SohamBhavsar24/vision-autonomous-robotic-arm/poster/index.html

A0 Poster Controls

ISO A0 (841 x 1189 mm) @ 300 DPI

Magnification Preset

35% 42% 50% 60% 75% 85% 100% 115% 125%

Fit Width Fit Window

50%

Global Image Fit

Fill (Cover) Fit Entire (Contain)

Auto-Fit All Slots to Photos

Global Alignment

Center Top Bottom

Save All Changes

Saved all cards, slots & images!

Print / Export A0 PDF Reset Slot Sizes Reset Card Sizes Clear All Images

Pro Controls:
• Click Save All Changes to permanently store all images and layout sizing.
• In print preview: set Margins to None and Paper to ISO A0.
• Center column has the complete vertical pipeline.
• Drag bottom handle of any card or stage to customize height.
• Use [-H], [+H], [Auto] on card headers to adjust.
• Use [+ Add Image Window] on any card to create new image slots.
• Drag bottom handle of any slot to resize height.
• Use [Auto] on slots or Auto-Fit All Slots in dock to snap heights to image aspect ratio (eliminates all cropping).
• Use [Fit/Fill] and [Pos] on each slot for framing.

Department of Electrical and Electronics Engineering

# Vision-Guided Autonomous 6-DOF Robotic Arm

Overhead OpenCV Perception & Edge Intelligence on Raspberry Pi 5

Soham Bhavsar// Toshal Kumbhar// Divyansh Dewangan

+ College Logo

Upload Horizontal Logo / Seal

✕

1

## Problem & Innovation

-H +H Auto

Core Manipulation Dilemma: Traditional fixed automation fails when target objects shift unpredictably, while complex neural vision models introduce high latency and require heavy GPUs incompatible with standalone microcontrollers.

- Decoupled Perception: ArUco planar homography extracts physical coordinates in centimeters at 30 FPS without GPU overhead.
- Autonomous Motion Control: Cosine S-Curve velocity profiling and coordinated joint trajectory synthesis guarantee smooth, zero-jerk positioning without mechanical shock.
- Digital Twin & Teleoperation: WebGL 3D simulation enforces workspace geofencing and zero-collision safety; PS5 controller enables precise manual teleoperation.

Fit/Fill Pos Auto -H +H ✕ Del

Drop Image: Physical 6-DOF Arm

3D-Printed Manipulator on 25x30cm Grid

+ Add Image Window

2

## Hardware Architecture & Actuation

-H +H Auto

Manipulator Specs: 3D-printed links powered by an isolated 6V 5Ah battery rail with emergency cut-off. Arm reach: 35.0 cm.

Joint / Link | Actuator | Role / Dimension
Base Yaw | MG996R (Ch 0) | Turntable Pivot - L1 = 9.5 cm
Shoulder | MG996R (Ch 1) | Upper Arm - L2 = 12.0 cm
Elbow | MG996R (Ch 2) | Forearm - L3 = 9.0 cm
Wrist Roll/Pitch | MG90S (Ch 3,4) | Continuous Roll & Pitch
Gripper | MG90S (Ch 5) | Dual-Gear Claw - L4 = 14.0 cm

Control: Arduino Uno serial bridge (115200 baud, 0xFF binary packets at 30Hz) driving PCA9685 via 400kHz Fast I2C. 500ms watchdog auto-home timer.

+ Add Image Window

3

## Complete Physical Setup

-H +H Auto

Baseplate Rig

40 x 40 cm Rigid Frame

Camera Tower

50 cm Overhead Mast

Table Surface

25 x 30 cm Calibrated Pad

Power Delivery

Dual-Rail Isolated + Cutoff

- Rigid Baseplate: Anchored 40x40 cm frame absorbs dynamic reaction torques during rapid multi-axis manipulator motions.
- Overhead Camera Mast: 50 cm orthogonal mount secures the RGB camera for unoccluded top-down perception across pickup sectors.
- Calibrated Surface: 25x30 cm pad establishes precise homography coordinate bounds, staging zones, and drop bins.
- Isolated Dual-Rail Power: 6V 5A battery rail absorbs servo current surges, 5V rail powers logic circuits, with an emergency cutoff toggle.

Fit/Fill Pos Auto -H +H ✕ Del

Drop Image: Complete Physical Setup

Robotic Arm, Camera Mast, Baseplate & Workcell Rig

+ Add Image Window

SYSTEM ARCHITECTURE

## End-to-End System Pipeline

7-Stage Closed-Loop Cyber-Physical Workflow

STAGE 01 Logitech C270 USB • 30 FPS

-H +H Auto

Overhead Vision Capture & Frame Acquisition

Rigid 50 cm overhead mount acquires 640x480 MJPEG video at 30 FPS with fixed exposure, capturing the full 25x30 cm table workspace without perspective occlusion or illumination flicker.

Fit/Fill Pos Auto -H +H ✕

Drop Camera Feed

STAGE 02 OpenCV 5.0 • Sub-Pixel Tracking

-H +H Auto

ArUco Marker Perception & Detection

Real-time binary fiducial tracking isolates base origin (Tag 2) and pick block (Tag 0) in < 12 ms; sub-pixel corner refinement ensures sub-millimeter centroid and heading accuracy.

Fit/Fill Pos Auto -H +H ✕

Drop ArUco Tracking

STAGE 03 Planar Matrix H • Perspective Projection

-H +H Auto

Metric Real-World Homography Mapping

Calibrated 3x3 homography matrix H maps 2D camera pixels [u, v, 1]ᵀ directly to real-world table coordinates [X_w, Y_w, 1]ᵀ in centimeters with < 0.5 mm spatial precision.

STAGE 04 Coordinated Joint Profile • Zero-Jerk

-H +H Auto

Autonomous Motion Synthesis & Trajectory Generation

Synthesizes smooth joint-space waypoints using Cosine S-Curve velocity profiling, ensuring zero-jerk transitions, eliminating mechanical shock, and avoiding gear backlash.

Fit/Fill Pos Auto -H +H ✕

Drop Motion Trajectory

STAGE 05 115200 Baud • 400kHz Fast I2C

-H +H Auto

Binary Serial Protocol & Low-Level Driver

Streams compact 6-byte binary angle frames at 30 Hz with 0xFF sync header framing to Arduino Uno, commanding PCA9685 12-bit PWM servos over 400kHz Fast I2C.

STAGE 06 MG996R & MG90S • Dual-Rail Power

-H +H Auto

6-DOF Manipulator Actuation & Grasp Execution

Multi-axis servo actuation executes approach, descent, clamping, lift, and placement powered by an isolated 6V 5A battery rail with an active 500ms safety watchdog.

Fit/Fill Pos Auto -H +H ✕

Drop Physical Pick Action

STAGE 07 WebGL Three.js • 60 FPS Shadow

-H +H Auto

Digital Twin Shadow Validation & Safety Geofence

60 FPS Three.js 3D simulation mirrors manipulator poses in Shadow Mode, enforcing virtual workspace geofencing and verifying collision-free trajectories before physical actuation.

Fit/Fill Pos Auto -H +H ✕

Drop Digital Twin Simulation

4

## Perception & Teleop

-H +H Auto

- OpenCV 5.0 Perception: 30 FPS MJPEG. Marker ID 2 sets base origin (0,0); Marker ID 0 tracks cube.
- Calibrated Metric Space: Homography matrix H maps pixels directly to centimeters: Xmax = 30cm, Ymax = 25cm.
- Controller Teleoperation: Teleoperation is conducted using a handheld PS5 DualSense controller in Direct Joint Jogging mode with Exponential Moving Average (EMA) filtering (α=0.25) for smooth demonstration collection and real-time manual override.

Fit/Fill Pos Auto -H +H ✕ Del

Drop Image: OpenCV Stream

ArUco Bounding Boxes & Metric HUD

+ Add Image Window

5

## Digital Twin Simulation

-H +H Auto

01

Sim-to-Real Discrepancy: Compares servo joint telemetry against camera vision to detect motor stalls.

02

Workspace Geofencing: Virtual barrier prevents link collisions with camera mount or table.

03

Policy Shadow Mode: New policy checkpoints execute inside the 3D twin first; only collision-free paths actuate motors.

Fit/Fill Pos Auto -H +H ✕ Del

Drop Image: 3D Twin Viewport

STL Mesh Rendering & 25x30cm Pad

+ Add Image Window

6

## Performance Metrics

-H +H Auto

< 15 ms

Perception Latency

30 Hz

Control Loop Rate

60 FPS

Twin Sync Rate

< 0.8 cm

Repeatability Error

17,824

Training State Pairs

5.9 s

Policy Train Time

Accuracy: Angular MSE of 0.4038 degrees across all 30 workspace cells. Zero-Jerk S-Curve smoothing reduced motor acceleration spikes by 87%.

+ Add Image Window

7

## Standalone Edge Intelligence

-H +H Auto

Autonomous Raspberry Pi 5 Deployment: The entire system runs directly on a Raspberry Pi 5 (4GB RAM) as a 100% self-contained cyber-physical robotic cell.

- On-Device Loop: OpenCV 5.0 vision at 30 FPS; PyTorch BC policy executes in < 5 ms.
- Zero Cloud Dependency: Completely air-gapped without external network or latency.
- Dual-Rail Battery Isolation: 6V 5Ah SLA battery for servos; 5V 5A PD rail for Pi 5 with a 500ms safety watchdog auto-home timer.

+ Add Image Window
