SohamBhavsar24/vision-autonomous-robotic-arm/Robotic_Arm_3D_Model.STEP/Robotic Arm 3D Model.STEP

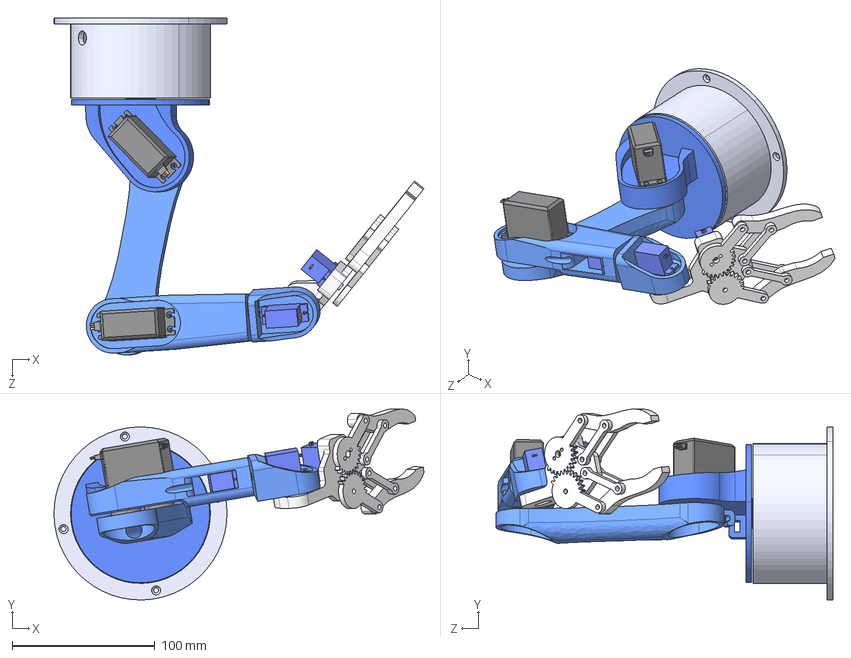
[picture p9: CAD file, 2026-09-26]
Robotic_Arm_3D_Model.STEP/Robotic Arm 3D Model.STEP
259.3 x 133.8 x 236.1 mm
Base
Servo Motor MG996R x 3
Waist
Arm 01
Servo Motor Micro 9g x 3
Arm 02 v3
Arm 03
gear1
gear2
grip link 1 x 4
Gripper base
Gripper 1 x 2
