SohamBhavsar24/vision-autonomous-robotic-arm/Robotic_Arm_3D_Model.STEP/grip link 1.STL

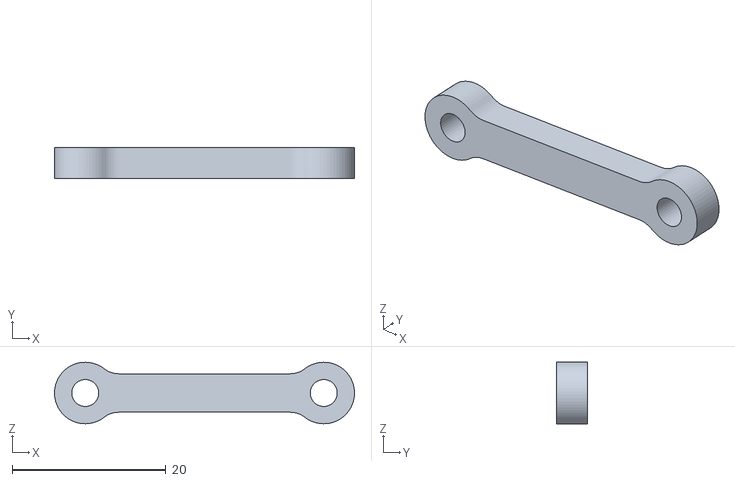
[picture p10: CAD file, 2026-09-20]
Robotic_Arm_3D_Model.STEP/grip link 1.STL
39.0 x 4.00 x 8.00
