SohamBhavsar24/vision-autonomous-robotic-arm/Robotic_Arm_3D_Model.STEP/Arm 03.STL

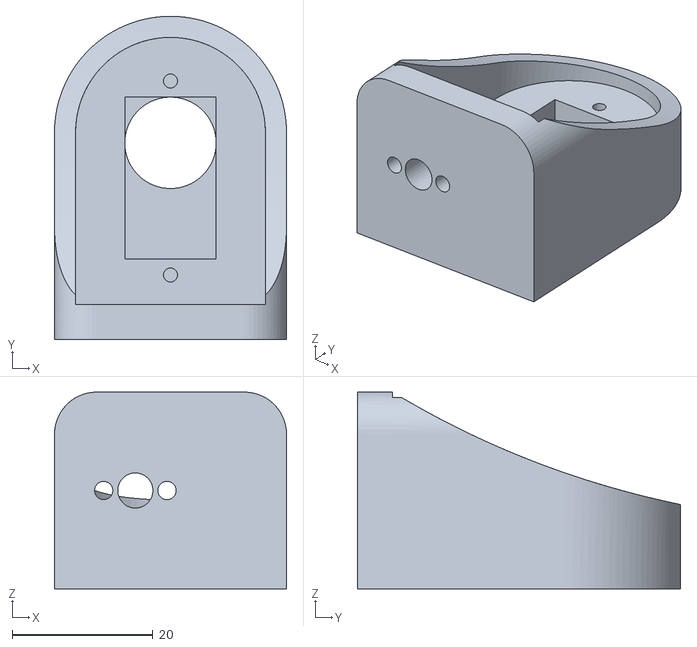
[picture p11: CAD file, 2026-09-20]
Robotic_Arm_3D_Model.STEP/Arm 03.STL
33.0 x 46.0 x 28.0
