SohamBhavsar24/vision-autonomous-robotic-arm/Robotic_Arm_3D_Model.STEP/Base.STL

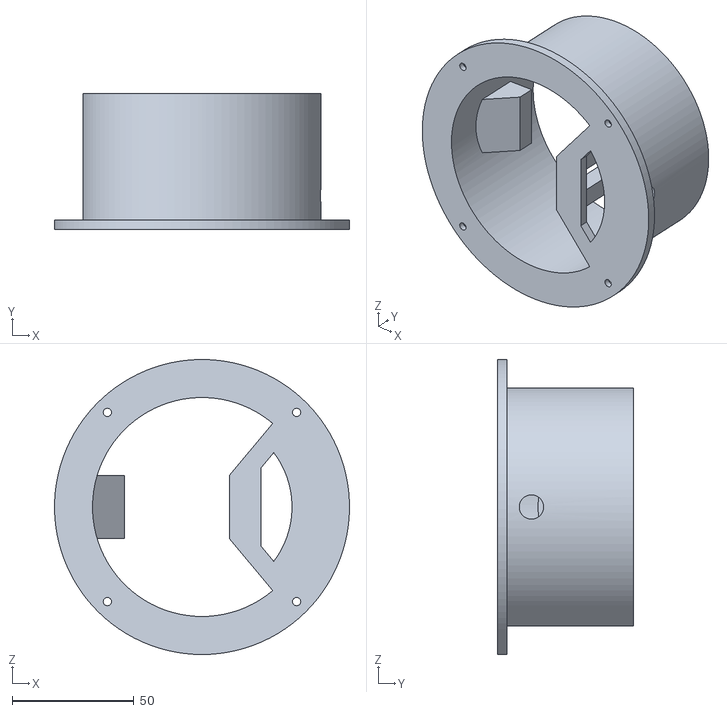
[picture p12: CAD file, 2026-09-20]
Robotic_Arm_3D_Model.STEP/Base.STL
121.2 x 56.0 x 121.2
