SohamBhavsar24/vision-autonomous-robotic-arm/Robotic_Arm_3D_Model.STEP/gear2.STL

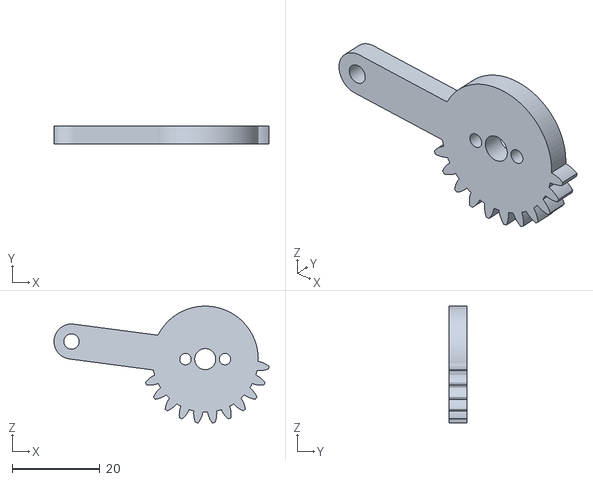
[picture p13: CAD file, 2026-09-20]
Robotic_Arm_3D_Model.STEP/gear2.STL
49.0 x 4.00 x 26.6
