SohamBhavsar24/vision-autonomous-robotic-arm/Robotic_Arm_3D_Model.STEP/Arm 01.STL

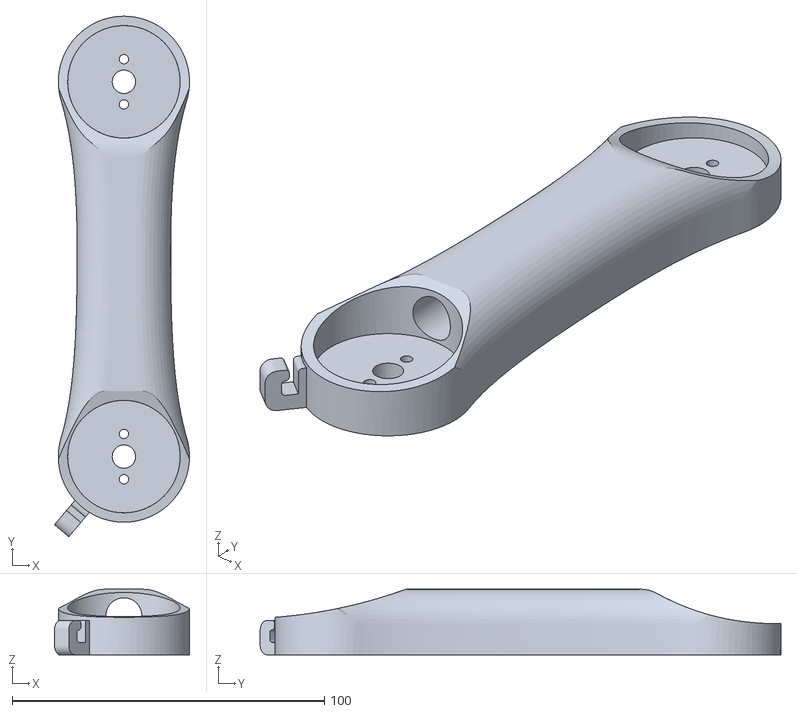
[picture p14: CAD file, 2026-09-20]
Robotic_Arm_3D_Model.STEP/Arm 01.STL
43.2 x 166.7 x 21.0
