SohamBhavsar24/vision-autonomous-robotic-arm/Robotic_Arm_3D_Model.STEP/Gripper base.STL

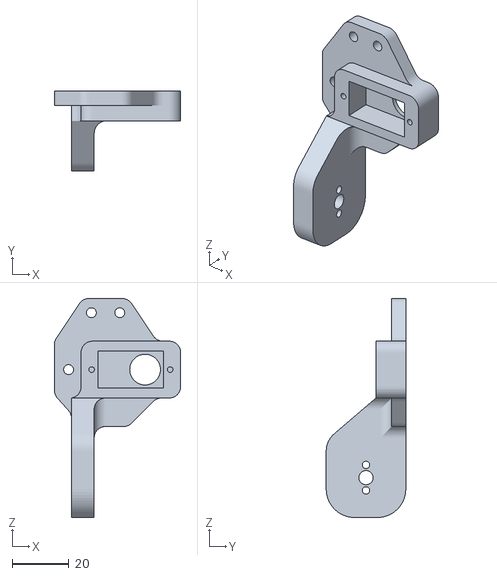
[picture p15: CAD file, 2026-09-20]
Robotic_Arm_3D_Model.STEP/Gripper base.STL
44.4 x 28.0 x 77.0
