SohamBhavsar24/vision-autonomous-robotic-arm/Robotic_Arm_3D_Model.STEP/Waist.STL

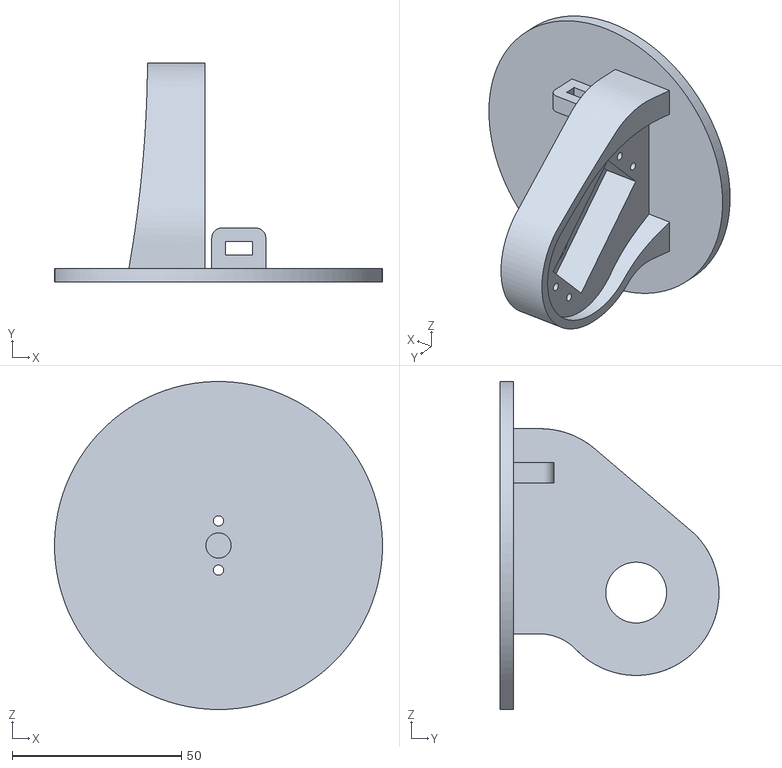
[picture p16: CAD file, 2026-09-20]
Robotic_Arm_3D_Model.STEP/Waist.STL
97.0 x 64.8 x 97.0
