SohamBhavsar24/vision-autonomous-robotic-arm/Robotic_Arm_3D_Model.STEP/Arm 02 v3.STL

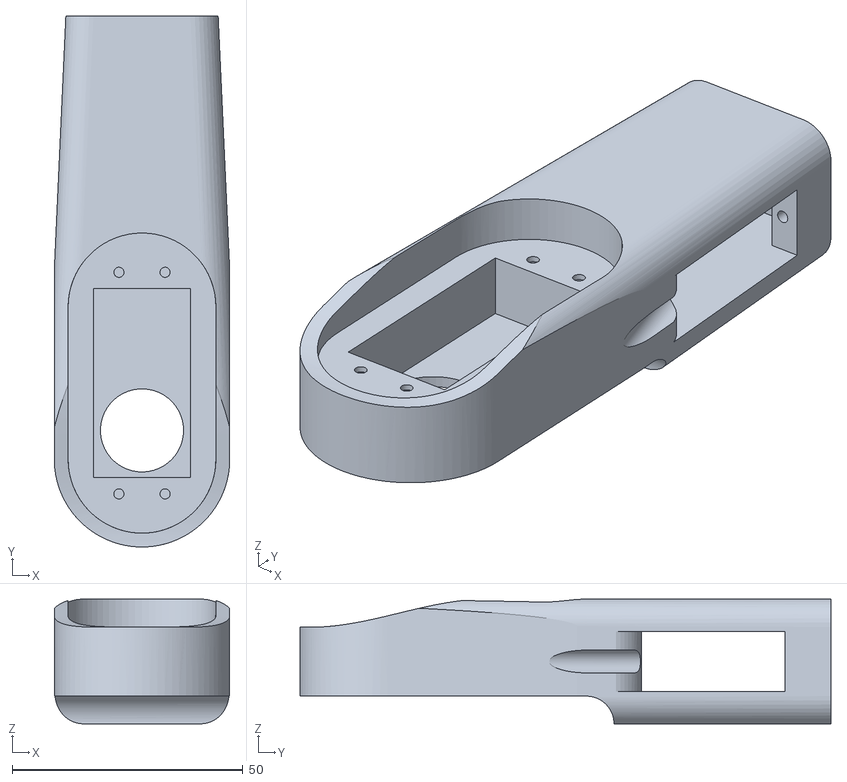
[picture p17: CAD file, 2026-09-20]
Robotic_Arm_3D_Model.STEP/Arm 02 v3.STL
38.0 x 115.0 x 27.0
