SohamBhavsar24/vision-autonomous-robotic-arm/Robotic_Arm_3D_Model.STEP/Gripper 1.STL

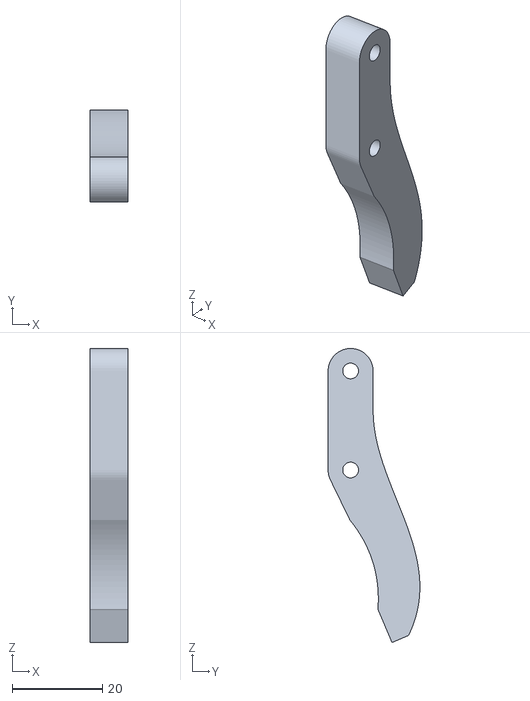
[picture p18: CAD file, 2026-09-20]
Robotic_Arm_3D_Model.STEP/Gripper 1.STL
8.50 x 20.4 x 65.3
