SohamBhavsar24/vision-autonomous-robotic-arm/(list of files, cad)

Other CAD files:
Robotic_Arm_3D_Model.STEP/gear1.STL
