SohamBhavsar24/vision-autonomous-robotic-arm/perception/aruco_markers/print_aruco_sheet.html

## Stage 1 Official ArUco Marker Print Sheet (DICT_4X4_50)

Mathematically Exact OpenCV Dictionary • Pre-scaled to 4cm × 4cm

Printing & Mounting Guide:

1. Click File → Print (or press Cmd+P / Ctrl+P).
2. In the Print Dialog, set Scale: 100% / Actual Size (do NOT fit to page).
3. Cut out each marker along the dashed outer border line.
4. CRITICAL STEP: Glue each cutout onto a flat piece of thin cardboard before sticking to the sponge cubes. Cardboard guarantees the marker stays 100% flat so vision detection works in variable lighting.
5. Attach Marker 0 to Block 1, Marker 1 to Block 2, and Marker 2 to Target Box.

Block 1 (Sponge Cube 1)

ArUco ID: 0 (4cm × 4cm)

Block 2 (Sponge Cube 2)

ArUco ID: 1 (4cm × 4cm)

Target Destination Box

ArUco ID: 2 (4cm × 4cm)
