SohamBhavsar24/vision-autonomous-robotic-arm/ps5_controller_test.html

# PS5 Controller Proof of Concept

Validating DualSense input via Browser Gamepad API

Press any button on your PS5 controller to connect...

## Analog Sticks

Left Stick

X: 0.00 Y: 0.00

Right Stick

X: 0.00 Y: 0.00

## Triggers & Bumpers

L2 Trigger

0%

R2 Trigger

0%

L1 Bumper

0%

R1 Bumper

0%

## Buttons

## Raw Axes

## Simulated Servo Mapping (Proof of Concept)

This shows how controller inputs would map to 6 servo angles (0°–180°). This is a placeholder mapping — the real IK solver will replace this.

Base (Ch 0) 90°

Shoulder (Ch 1) 90°

Elbow (Ch 2) 90°

Wrist Pitch (Ch 3) 90°

Wrist Roll (Ch 4) 90°

Gripper (Ch 5) 10°

How to test: Connect your PS5 DualSense controller via USB or Bluetooth to your Mac. Open this page in Chrome or Edge. Press any button on the controller — the browser will detect it automatically via the Gamepad API. Move the sticks and triggers to see live input values.

What this proves: That we can read all PS5 controller inputs (sticks, triggers, buttons) in real-time through a web browser with zero dependencies. The actual project will use a Python backend (FastAPI + pygame/pyserial) to read the controller and send commands to the Arduino — but this confirms the DualSense hardware works and is readable on your Mac.
