SohamBhavsar24/vision-autonomous-robotic-arm/dashboard/backend/main.py

"""
==============================================================================
DASHBOARD FASTAPI BACKEND SERVER
==============================================================================

Project:  Vision-Based Autonomous Robotic Arm
File:     main.py
Location: dashboard/backend/

PURPOSE:
    Asynchronous web server providing REST endpoints and WebSocket real-time
    communication for the Dashboard UI. Serves the static Warm Cream HTML/CSS/JS
    frontend and interfaces directly with serial_manager.py.

KEY ENDPOINTS:
    - GET  /api/ports             Lists available serial ports
    - POST /api/connect           Connects to a specific serial port
    - POST /api/disconnect        Disconnects from Arduino
    - POST /api/lock90            Locks all 6 servos at 90° for assembly
    - POST /api/home              Moves all servos to Home Position
    - POST /api/estop             Triggers Emergency Stop
    - POST /api/estop/reset       Resets Emergency Stop state
    - WS   /ws                    Real-time WebSocket for telemetry & slider streaming

RELATED DECISIONS:
    - Decision #11: Web-based Dashboard (FastAPI + WebSockets)
    - Decision #15: No authentication required
    - Decision #18: Warm light cream theme support
    - Decision #19: Active physical assembly tool
==============================================================================
"""

import os
import json
import asyncio
import logging
import urllib.request
import urllib.error
from typing import List, Dict, Any, Optional
from fastapi import FastAPI, WebSocket, WebSocketDisconnect, HTTPException, UploadFile, File
from fastapi.responses import StreamingResponse
from fastapi.staticfiles import StaticFiles
from fastapi.middleware.cors import CORSMiddleware
from pydantic import BaseModel

from serial_manager import serial_manager
from vision_manager import vision_manager_cam1
from ik_solver import ik_solver
from autonomous_runner import AutonomousRunner

autonomous_runner = AutonomousRunner(serial_manager=serial_manager, vision_manager=vision_manager_cam1)

logging.basicConfig(level=logging.INFO, format="%(asctime)s [%(levelname)s] %(message)s")
logger = logging.getLogger("DashboardBackend")

app = FastAPI(
    title="Robotic Arm Control Dashboard Backend",
    version="1.0.0"
)

UPLOADS_DIR = os.path.abspath(os.path.join(os.path.dirname(__file__), "../frontend/uploads"))
os.makedirs(UPLOADS_DIR, exist_ok=True)

def _load_env_file():
    possible_paths = [
        os.path.abspath(os.path.join(os.path.dirname(__file__), "../../.env")),
        os.path.abspath(os.path.join(os.path.dirname(__file__), ".env")),
        os.path.abspath(".env")
    ]
    for p in possible_paths:
        if os.path.exists(p):
            try:
                with open(p, "r", encoding="utf-8") as f:
                    for line in f:
                        line = line.strip()
                        if line and not line.startswith("#") and "=" in line:
                            k, v = line.split("=", 1)
                            os.environ.setdefault(k.strip(), v.strip().strip("'\""))
                break
            except Exception:
                pass

_load_env_file()

SUPABASE_URL = os.environ.get("SUPABASE_URL", "")
SUPABASE_KEY = os.environ.get("SUPABASE_KEY", "")

@app.post("/api/upload")
async def upload_media_file(file: UploadFile = File(...)):
    """Uploads media (video/photo/doc) locally and syncs to Supabase Cloud Storage."""
    clean_name = f"{int(asyncio.get_event_loop().time() * 1000)}_{file.filename.replace(' ', '_')}"
    local_path = os.path.join(UPLOADS_DIR, clean_name)
    
    contents = await file.read()
    with open(local_path, "wb") as f:
        f.write(contents)
        
    public_url = f"/uploads/{clean_name}"
    
    # Attempt background sync to Supabase Cloud Storage if credentials exist
    if SUPABASE_URL and SUPABASE_KEY:
        try:
            supa_url = f"{SUPABASE_URL}/storage/v1/object/journal-media/{clean_name}"
            req = urllib.request.Request(supa_url, data=contents, method="POST")
            req.add_header("apikey", SUPABASE_KEY)
            req.add_header("Authorization", f"Bearer {SUPABASE_KEY}")
            req.add_header("x-upsert", "true")
            req.add_header("Content-Type", file.content_type or "application/octet-stream")
            
            with urllib.request.urlopen(req) as resp:
                if resp.status in (200, 201):
                    public_url = f"{SUPABASE_URL}/storage/v1/object/public/journal-media/{clean_name}"
        except Exception as e:
            logger.warning(f"Cloud storage sync warning (using local URL): {e}")

    file_ext = file.filename.split(".")[-1].lower() if "." in file.filename else ""
    return {
        "status": "success",
        "name": file.filename,
        "type": file_ext,
        "url": public_url
    }

# Allow CORS for development
app.add_middleware(
    CORSMiddleware,
    allow_origins=["*"],
    allow_credentials=True,
    allow_methods=["*"],
    allow_headers=["*"],
)

# Track active WebSocket connections
active_connections: List[WebSocket] = []


# Request Models
class ConnectRequest(BaseModel):
    port: str
    baudrate: int = 115200


class ServoAnglesRequest(BaseModel):
    angles: List[int]


CONFIG_PATH = os.path.abspath(os.path.join(os.path.dirname(__file__), "kinematics_config.json"))
CLAW_CONFIG_PATH = os.path.abspath(os.path.join(os.path.dirname(__file__), "claw_config.json"))
CAMERA_CONFIG_PATH = os.path.abspath(os.path.join(os.path.dirname(__file__), "camera_config.json"))
JOURNAL_PATH = os.path.abspath(os.path.join(os.path.dirname(__file__), "journal_entries.json"))
DATASET_PATH = os.path.abspath(os.path.join(os.path.dirname(__file__), "dataset_episodes.json"))
DROP_LOCATIONS_PATH = os.path.abspath(os.path.join(os.path.dirname(__file__), "drop_locations.json"))
DATASETS_DIR = os.path.abspath(os.path.join(os.path.dirname(__file__), "datasets"))
os.makedirs(DATASETS_DIR, exist_ok=True)

class KinematicsConfigRequest(BaseModel):
    L1: float = 9.5
    L2: float = 12.0
    L3: float = 9.0
    L4: float = 14.0
    offsets: List[int] = [0, 0, 0, 0, 0, 0]
    gripper_closed: int = 85
    gripper_open: int = 140

class IKSolveRequest(BaseModel):
    x: float
    y: float
    z: float
    pitch_deg: float = 45.0
    roll_deg: float = 90.0
    gripper_angle: int = 140

class JournalEntriesRequest(BaseModel):
    entries: List[Dict[str, Any]]

class DatasetEpisodesRequest(BaseModel):
    episodes: List[Dict[str, Any]]

class DropLocationsSaveRequest(BaseModel):
    target_id: Optional[str] = None
    name: Optional[str] = None
    angles: Optional[List[int]] = None
    description: Optional[str] = None
    locations: Optional[Dict[str, Any]] = None

class AutonomousStartRequest(BaseModel):
    model_id: str = "v1"
    continuous: bool = True

class TrainModelRequest(BaseModel):
    version_id: str = "v1"
    model_name: str = "v1 (30 Demos)"
    epochs: int = 80
    include_theta: Optional[bool] = None
    architecture: str = "mlp"


from dataset_formatter import save_compact_dataset_file, save_individual_episodes, load_individual_episodes

@app.on_event("shutdown")
def shutdown_event():
    logger.info("Stopping vision manager camera streams...")
    vision_manager_cam1.stop_camera()


@app.get("/api/video_feed/1")
async def video_feed_cam1():
    """Live MJPEG video feed for Camera 1 (Logitech C270 Workspace View) with real-time OpenCV ArUco Marker ID 0 detection."""
    return StreamingResponse(
        vision_manager_cam1.generate_mjpeg_stream(),
        media_type="multipart/x-mixed-replace; boundary=frame"
    )


@app.get("/api/vision/status")
async def get_vision_status():
    """Returns camera connection status, detected ArUco IDs, and real-world block pose relative to Origin Tag ID 2."""
    return {
        "camera1_connected": vision_manager_cam1.is_camera_connected,
        "detected_marker_ids": vision_manager_cam1.last_detected_ids,
        "latest_block_pose": vision_manager_cam1.latest_block_pose
    }


@app.get("/api/dataset")
async def get_dataset_episodes():
    """Returns persistent list of recorded demonstration episodes from individual JSON files."""
    return load_individual_episodes(DATASETS_DIR, DATASET_PATH)


@app.post("/api/dataset")
async def save_dataset_episodes(req: DatasetEpisodesRequest):
    """Saves persistent list of demonstration episodes into individual episode_XXX.json files in datasets/."""
    save_individual_episodes(req.episodes, DATASETS_DIR, DATASET_PATH)
    return {"status": "saved", "count": len(req.episodes)}


@app.get("/api/journal")
async def get_journal_entries():
    """Returns shared master list of journal entries."""
    if os.path.exists(JOURNAL_PATH):
        try:
            with open(JOURNAL_PATH, "r") as f:
                return json.load(f)
        except Exception:
            pass

    # Fallback to Supabase if local file does not exist but credentials do
    if SUPABASE_URL and SUPABASE_KEY:
        try:
            endpoint = f"{SUPABASE_URL}/rest/v1/journal_entries?select=*&order=created_at.desc"
            req = urllib.request.Request(endpoint)
            req.add_header("apikey", SUPABASE_KEY)
            req.add_header("Authorization", f"Bearer {SUPABASE_KEY}")
            with urllib.request.urlopen(req, timeout=5) as resp:
                if resp.status == 200:
                    data = json.loads(resp.read().decode("utf-8"))
                    if isinstance(data, list):
                        return data
        except Exception as e:
            logger.warning(f"Supabase journal fetch warning: {e}")

    return []


@app.post("/api/journal")
async def save_journal_entries(req: JournalEntriesRequest):
    """Saves shared master list of journal entries to backend file and syncs to Supabase."""
    with open(JOURNAL_PATH, "w") as f:
        json.dump(req.entries, f, indent=2)

    # Sync to Supabase PostgreSQL table if credentials exist
    if SUPABASE_URL and SUPABASE_KEY:
        try:
            endpoint = f"{SUPABASE_URL}/rest/v1/journal_entries"
            data = json.dumps(req.entries).encode("utf-8")
            sync_req = urllib.request.Request(endpoint, data=data, method="POST")
            sync_req.add_header("apikey", SUPABASE_KEY)
            sync_req.add_header("Authorization", f"Bearer {SUPABASE_KEY}")
            sync_req.add_header("Content-Type", "application/json")
            sync_req.add_header("Prefer", "resolution=merge-duplicates,return=representation")
            with urllib.request.urlopen(sync_req, timeout=5) as resp:
                pass
        except Exception as e:
            logger.warning(f"Supabase journal sync warning: {e}")

    return {"status": "saved", "count": len(req.entries)}


@app.delete("/api/journal")
@app.delete("/api/journal/{entry_id}")
async def delete_journal_entry(entry_id: Optional[str] = None, id: Optional[str] = None):
    """Deletes an entry from local JSON and Supabase if configured."""
    target_id = entry_id or id
    if not target_id:
        raise HTTPException(status_code=400, detail="Missing entry id")

    if os.path.exists(JOURNAL_PATH):
        try:
            with open(JOURNAL_PATH, "r") as f:
                entries = json.load(f)
            entries = [e for e in entries if e.get("id") != target_id]
            with open(JOURNAL_PATH, "w") as f:
                json.dump(entries, f, indent=2)
        except Exception as e:
            logger.warning(f"Local entry delete warning: {e}")

    if SUPABASE_URL and SUPABASE_KEY:
        try:
            endpoint = f"{SUPABASE_URL}/rest/v1/journal_entries?id=eq.{target_id}"
            del_req = urllib.request.Request(endpoint, method="DELETE")
            del_req.add_header("apikey", SUPABASE_KEY)
            del_req.add_header("Authorization", f"Bearer {SUPABASE_KEY}")
            with urllib.request.urlopen(del_req, timeout=5) as resp:
                pass
        except Exception as e:
            logger.warning(f"Supabase entry delete warning: {e}")

    return {"status": "deleted", "id": target_id}


@app.get("/api/kinematics")
async def get_kinematics_config():
    """Returns persistent Kinematic Calibration parameters."""
    if os.path.exists(CONFIG_PATH):
        try:
            with open(CONFIG_PATH, "r") as f:
                return json.load(f)
        except Exception:
            pass
    return {
        "L1": 9.5, "L2": 12.0, "L3": 9.0, "L4": 14.0,
        "offsets": [0, 0, 0, 0, 0, 0],
        "gripper_closed": 85, "gripper_open": 140
    }


@app.post("/api/kinematics")
async def save_kinematics_config(req: KinematicsConfigRequest):
    """Saves updated Kinematic Calibration parameters (L1-L4, offsets, gripper angles) and syncs to ik_solver and serial_manager."""
    data = req.model_dump()
    with open(CONFIG_PATH, "w") as f:
        json.dump(data, f, indent=2)
    ik_solver.L1 = req.L1
    ik_solver.L2 = req.L2
    ik_solver.L3 = req.L3
    ik_solver.L4 = req.L4
    serial_manager.gripper_open = req.gripper_open
    serial_manager.gripper_closed = req.gripper_closed
    return {"status": "saved", "config": data}


@app.get("/api/digital_twin/claw_config")
async def get_claw_config():
    """Returns persistent digital twin claw placement parameters."""
    if os.path.exists(CLAW_CONFIG_PATH):
        try:
            with open(CLAW_CONFIG_PATH, "r") as f:
                return json.load(f)
        except Exception as e:
            logger.warning(f"Error loading claw_config.json: {e}")
    return {}


@app.post("/api/digital_twin/claw_config")
async def save_claw_config(config: dict):
    """Saves updated digital twin claw placement parameters."""
    try:
        with open(CLAW_CONFIG_PATH, "w") as f:
            json.dump(config, f, indent=2)
        return {"status": "saved", "config": config}
    except Exception as e:
        logger.error(f"Error saving claw_config.json: {e}")
        return {"status": "error", "message": str(e)}


@app.get("/api/digital_twin/camera_default")
async def get_camera_default():
    """Returns persistent digital twin default camera viewpoint."""
    if os.path.exists(CAMERA_CONFIG_PATH):
        try:
            with open(CAMERA_CONFIG_PATH, "r") as f:
                return json.load(f)
        except Exception as e:
            logger.warning(f"Error loading camera_config.json: {e}")
    return {}


@app.post("/api/digital_twin/camera_default")
async def save_camera_default(config: dict):
    """Saves updated digital twin default camera viewpoint to disk."""
    try:
        with open(CAMERA_CONFIG_PATH, "w") as f:
            json.dump(config, f, indent=2)
        return {"status": "saved", "config": config}
    except Exception as e:
        logger.error(f"Error saving camera_config.json: {e}")
        return {"status": "error", "message": str(e)}


def load_drop_locations_dict() -> Dict[str, Any]:
    """Loads drop_locations.json or returns and initializes default locations."""
    if os.path.exists(DROP_LOCATIONS_PATH):
        try:
            with open(DROP_LOCATIONS_PATH, "r") as f:
                return json.load(f)
        except Exception as e:
            logger.warning(f"Error loading drop_locations.json: {e}")
    default_locs = {
        "block_1": {
            "name": "Block 1 Drop Target (Tag 0)",
            "angles": [140, 80, 85, 90, 90],
            "description": "Calibrated drop target for Block 1 (ArUco ID 0) left bin"
        },
        "block_2": {
            "name": "Block 2 Drop Target (Tag 1)",
            "angles": [155, 80, 85, 90, 90],
            "description": "Calibrated drop target for Block 2 (ArUco ID 1) outer left bin"
        }
    }
    try:
        with open(DROP_LOCATIONS_PATH, "w") as f:
            json.dump(default_locs, f, indent=2)
    except Exception as e:
        logger.error(f"Error initializing drop_locations.json: {e}")
    return default_locs


@app.get("/api/drop_locations")
async def get_drop_locations():
    """Returns persistent calibrated drop targets for Block 1, Block 2, and high-clearance transit waypoint."""
    data = load_drop_locations_dict()
    return {"status": "success", "locations": data}


@app.post("/api/drop_locations")
async def save_drop_locations(req: DropLocationsSaveRequest):
    """
    Saves updated drop target coordinates.
    Supports single-target updates (target_id + angles) or bulk updates (locations dict).
    Stores only the 5 arm kinematic joint angles [θ1..θ5], strictly adhering to Decision #37.
    """
    current_data = load_drop_locations_dict()

    if req.target_id and req.angles is not None:
        clamped_angles = [max(0, min(180, int(round(a)))) for a in req.angles[:5]]
        if len(clamped_angles) < 5:
            raise HTTPException(status_code=400, detail="Drop location must specify 5 arm joint angles [θ1..θ5].")
        target_info = current_data.get(req.target_id, {})
        target_info["angles"] = clamped_angles
        if req.name:
            target_info["name"] = req.name
        if req.description:
            target_info["description"] = req.description
        current_data[req.target_id] = target_info

    elif req.locations:
        for tid, tinfo in req.locations.items():
            if isinstance(tinfo, dict) and "angles" in tinfo:
                clamped_angles = [max(0, min(180, int(round(a)))) for a in tinfo["angles"][:5]]
                if len(clamped_angles) == 5:
                    target_entry = current_data.get(tid, {})
                    target_entry["angles"] = clamped_angles
                    if "name" in tinfo:
                        target_entry["name"] = tinfo["name"]
                    if "description" in tinfo:
                        target_entry["description"] = tinfo["description"]
                    current_data[tid] = target_entry

    try:
        with open(DROP_LOCATIONS_PATH, "w") as f:
            json.dump(current_data, f, indent=2)
        return {"status": "saved", "locations": current_data}
    except Exception as e:
        logger.error(f"Error saving drop_locations.json: {e}")
        return {"status": "error", "message": str(e)}


@app.post("/api/drop_locations/test/{target_id}")
async def test_drop_location_pose(target_id: str):
    """
    Executes a smooth zero-jerk Cosine S-Curve test transition to the specified calibrated drop pose.
    Dynamically loads the live open gripper angle from serial_manager (Decision #37).
    """
    locations = load_drop_locations_dict()
    if target_id not in locations:
        raise HTTPException(status_code=404, detail=f"Target drop location '{target_id}' not found.")

    target_angles_5 = locations[target_id]["angles"][:5]
    open_angle = getattr(serial_manager, "gripper_open", 140)
    target_angles_6 = target_angles_5 + [open_angle]

    success, msg = await serial_manager.smooth_transition_to_angles(
        target_angles_6,
        duration_sec=1.5
    )
    return {
        "status": "success" if success else "error",
        "message": msg,
        "target_id": target_id,
        "angles": target_angles_6
    }


@app.post("/api/drop_locations/test_sequence/{target_id}")
async def test_drop_location_sequence(target_id: str):
    """
    Executes complete decoupled transfer test sequence:
    1. Smooth S-Curve directly to target drop pose (holding block)
    2. Momentarily commands calibrated open angle to release (Decision #37)
    3. Smooth S-Curve return directly to Home position
    """
    locations = load_drop_locations_dict()
    if target_id not in locations:
        raise HTTPException(status_code=404, detail=f"Target drop location '{target_id}' not found.")

    target_angles_5 = locations[target_id]["angles"][:5]
    open_angle = getattr(serial_manager, "gripper_open", 140)
    closed_angle = getattr(serial_manager, "gripper_closed", 85)

    # 1. Target Drop Bin (holding block)
    drop_angles = target_angles_5 + [closed_angle]
    ok, msg = await serial_manager.smooth_transition_to_angles(drop_angles, duration_sec=1.2)
    if not ok:
        return {"status": "error", "message": f"Drop pose failed: {msg}"}

    # 2. Release gripper (dynamically use open angle)
    release_angles = target_angles_5 + [open_angle]
    ok, msg = await serial_manager.smooth_transition_to_angles(release_angles, duration_sec=0.5)
    await asyncio.sleep(0.3)

    # 3. Return smoothly directly to Home
    ok, msg = await serial_manager.move_to_home()
    return {"status": "success", "message": f"Drop sequence for '{target_id}' completed successfully."}


@app.post("/api/ik/solve")
async def solve_ik_endpoint(req: IKSolveRequest):
    """Solves 3D Analytical Inverse Kinematics for target (X, Y, Z) in cm."""
    angles, reachable, msg = ik_solver.solve_ik(
        x=req.x, y=req.y, z=req.z,
        pitch_deg=req.pitch_deg, roll_deg=req.roll_deg,
        gripper_angle=req.gripper_angle
    )
    return {
        "status": "success" if reachable else "warning",
        "reachable": reachable,
        "angles": angles,
        "message": msg,
        "target": {"x": req.x, "y": req.y, "z": req.z, "pitch_deg": req.pitch_deg, "roll_deg": req.roll_deg}
    }


@app.post("/api/ik/move")
async def move_ik_endpoint(req: IKSolveRequest):
    """Solves 3D IK and smoothly dispatches calculated joint angles to physical servos."""
    angles, reachable, msg = ik_solver.solve_ik(
        x=req.x, y=req.y, z=req.z,
        pitch_deg=req.pitch_deg, roll_deg=req.roll_deg,
        gripper_angle=req.gripper_angle
    )
    success, send_msg = serial_manager.send_angles(angles)
    await broadcast_status()
    return {
        "status": "success" if (reachable and success) else "warning",
        "reachable": reachable,
        "angles": angles,
        "message": f"{msg} | Serial: {send_msg}",
        "target": {"x": req.x, "y": req.y, "z": req.z, "pitch_deg": req.pitch_deg, "roll_deg": req.roll_deg}
    }


@app.get("/api/fk")
async def get_forward_kinematics():
    """Computes and returns current 3D Cartesian coordinates (X, Y, Z in cm) of the physical arm."""
    current_angles = serial_manager.current_angles
    fk_res = ik_solver.forward_kinematics(*current_angles)
    return {
        "status": "success",
        "current_angles": current_angles,
        "cartesian": fk_res
    }


@app.get("/api/ports")
async def list_ports():
    """Lists available serial ports."""
    return {"ports": serial_manager.list_available_ports()}


@app.post("/api/connect")
async def connect_port(req: ConnectRequest):
    """Connects to specified serial port."""
    success, msg = serial_manager.connect(req.port, req.baudrate)
    if not success:
        raise HTTPException(status_code=400, detail=msg)
    await broadcast_status()
    return {"status": "connected", "message": msg}


@app.post("/api/auto-connect")
async def auto_connect_port():
    """Auto-detects and connects to Arduino."""
    success, msg = serial_manager.auto_connect()
    if not success:
        raise HTTPException(status_code=400, detail=msg)
    await broadcast_status()
    return {"status": "connected", "message": msg}


@app.post("/api/disconnect")
async def disconnect_port():
    """Disconnects serial connection."""
    success, msg = serial_manager.disconnect()
    await broadcast_status()
    return {"status": "disconnected", "message": msg}


@app.post("/api/servos")
async def set_servo_angles(req: ServoAnglesRequest):
    """Sets 6 servo angles (0–180)."""
    success, msg = serial_manager.send_angles(req.angles)
    if not success:
        raise HTTPException(status_code=400, detail=msg)
    await broadcast_status()
    return {"status": "success", "angles": serial_manager.current_angles}


@app.post("/api/lock90")
async def lock_all_90():
    """Locks all servos at 90° for assembly (Decision #19)."""
    asyncio.create_task(serial_manager.lock_all_90(broadcast_callback=broadcast_status))
    return {"status": "success", "message": "Locking all servos at 90°"}


@app.post("/api/home")
async def move_home():
    """Moves all servos to Home Position."""
    asyncio.create_task(serial_manager.move_to_home(broadcast_callback=broadcast_status))
    return {"status": "success", "message": "Moving to Home Position"}


@app.post("/api/servos/test/{servo_index}")
async def test_servo(servo_index: int):
    """Performs a solo sweep test on a single servo for assembly diagnostics."""
    asyncio.create_task(serial_manager.test_single_servo(servo_index, broadcast_callback=broadcast_status))
    return {"status": "success", "message": f"Testing Servo {servo_index}"}


@app.post("/api/estop")
async def emergency_stop():
    """Triggers Emergency Stop."""
    success, msg = serial_manager.emergency_stop()
    await broadcast_status()
    return {"status": "estop_active", "message": msg}


@app.post("/api/estop/reset")
async def reset_estop():
    """Resets Emergency Stop state."""
    success, msg = serial_manager.reset_estop()
    await broadcast_status()
    return {"status": "estop_reset", "message": msg}


# Autonomous Policy Execution Endpoints (Phase D)

@app.get("/api/models")
async def get_models():
    """Returns list of registered trained model versions."""
    return {"models": autonomous_runner.get_available_models()}


@app.post("/api/models/train")
async def train_new_model(req: TrainModelRequest):
    """Triggers policy training on recorded dataset episodes."""
    if req.architecture.lower() == "act" or req.version_id.startswith("act_") or "act" in req.model_name.lower():
        from train_act_engine import train_act_model
        meta = train_act_model(
            version_id=req.version_id,
            model_name=req.model_name,
            epochs=req.epochs or 30,
            include_theta=req.include_theta
        )
    else:
        from train_policy_engine import train_model
        meta = train_model(version_id=req.version_id, model_name=req.model_name, epochs=req.epochs, include_theta=req.include_theta)
    await broadcast_status()
    return {"status": "trained", "model": meta}


@app.delete("/api/models/{model_id}")
@app.post("/api/models/{model_id}/delete")
async def delete_model_endpoint(model_id: str):
    """Deletes a registered trained policy model and removes its file from disk."""
    if autonomous_runner.is_running and autonomous_runner.current_model_id == model_id:
        raise HTTPException(status_code=400, detail="Cannot delete model while autonomous execution is active.")
        
    success, msg = autonomous_runner.delete_model(model_id)
    if not success:
        raise HTTPException(status_code=404, detail=msg)
        
    await broadcast_status()
    return {"status": "deleted", "message": msg}


@app.get("/api/autonomous/status")
async def get_autonomous_status():
    """Returns live execution status, phase, and progress of the autonomous runner."""
    return autonomous_runner.get_status()


@app.post("/api/autonomous/start")
async def start_autonomous_execution(req: AutonomousStartRequest):
    """Starts autonomous pick-and-place execution using the selected model."""
    if autonomous_runner.is_running or autonomous_runner.is_loop_active:
        raise HTTPException(status_code=400, detail="Autonomous execution is already active.")
    
    if req.continuous:
        success, msg = autonomous_runner.start_autonomous_loop(
            model_id=req.model_id,
            broadcast_callback=broadcast_status
        )
        if not success:
            raise HTTPException(status_code=400, detail=msg)
        await broadcast_status()
        return {"status": "started", "mode": "continuous", "model_id": req.model_id}
    else:
        asyncio.create_task(autonomous_runner.run_autonomous_policy(
            model_id=req.model_id,
            broadcast_callback=broadcast_status
        ))
        return {"status": "started", "mode": "single", "model_id": req.model_id}


@app.post("/api/autonomous/stop")
async def stop_autonomous_execution():
    """Aborts or stops the active autonomous execution."""
    success, msg = autonomous_runner.stop_autonomous_loop()
    await broadcast_status()
    return {"status": "stopped" if success else "failed", "message": msg}


# WebSocket Handler for Real-Time Telemetry & Slider Control

@app.websocket("/ws")
async def websocket_endpoint(websocket: WebSocket):
    await websocket.accept()
    active_connections.append(websocket)
    logger.info("New WebSocket client connected.")
    
    # Send initial status on connect
    initial_status = serial_manager.get_status()
    initial_status["latest_block_pose"] = vision_manager_cam1.latest_block_pose
    await websocket.send_json({"type": "status", "data": initial_status})

    try:
        while True:
            data_str = await websocket.receive_text()
            try:
                data = json.loads(data_str)
                action_type = data.get("type")

                if action_type == "set_angles":
                    angles = data.get("angles", [])
                    serial_manager.send_angles(angles)
                    await broadcast_status()

                elif action_type == "move_ik":
                    x = float(data.get("x", 0.0))
                    y = float(data.get("y", 20.0))
                    z = float(data.get("z", 5.0))
                    pitch_deg = float(data.get("pitch_deg", -30.0))
                    roll_deg = float(data.get("roll_deg", 90.0))
                    gripper_angle = int(data.get("gripper_angle", 140))
                    angles, reachable, msg = ik_solver.solve_ik(x, y, z, pitch_deg, roll_deg, gripper_angle)
                    serial_manager.send_angles(angles)
                    await broadcast_status()

                elif action_type == "lock90":
                    asyncio.create_task(serial_manager.lock_all_90(broadcast_callback=broadcast_status))

                elif action_type == "home":
                    asyncio.create_task(serial_manager.move_to_home(broadcast_callback=broadcast_status))

                elif action_type == "sweep":
                    asyncio.create_task(serial_manager.run_joint_sweep_test(broadcast_callback=broadcast_status))

                elif action_type == "test_servo":
                    servo_index = int(data.get("index", 0))
                    asyncio.create_task(serial_manager.test_single_servo(servo_index, broadcast_callback=broadcast_status))

                elif action_type == "estop":
                    serial_manager.emergency_stop()
                    await broadcast_status()

                elif action_type == "reset_estop":
                    serial_manager.reset_estop()
                    await broadcast_status()

                elif action_type == "run_autonomous":
                    m_id = data.get("model_id", "v1")
                    continuous = data.get("continuous", True)
                    if continuous:
                        if not autonomous_runner.is_loop_active and not autonomous_runner.is_running:
                            autonomous_runner.start_autonomous_loop(
                                model_id=m_id,
                                broadcast_callback=broadcast_status
                            )
                            await broadcast_status()
                    else:
                        if not autonomous_runner.is_running and not autonomous_runner.is_loop_active:
                            asyncio.create_task(autonomous_runner.run_autonomous_policy(
                                model_id=m_id,
                                broadcast_callback=broadcast_status
                            ))

                elif action_type == "stop_autonomous":
                    autonomous_runner.stop_autonomous_loop()
                    await broadcast_status()

            except json.JSONDecodeError:
                logger.warning("Received non-JSON WebSocket message.")

    except WebSocketDisconnect:
        active_connections.remove(websocket)
        logger.info("WebSocket client disconnected.")


async def broadcast_status():
    """Broadcasts current status to all connected WebSocket clients."""
    if not active_connections:
        return
    serial_status = serial_manager.get_status()
    serial_status["latest_block_pose"] = vision_manager_cam1.latest_block_pose
    status_data = {
        "type": "status",
        "data": serial_status,
        "autonomous": autonomous_runner.get_status(),
        "vision": vision_manager_cam1.latest_block_pose
    }
    for conn in list(active_connections):
        try:
            await conn.send_json(status_data)
        except Exception:
            if conn in active_connections:
                active_connections.remove(conn)


# Mount static frontend files
FRONTEND_DIR = os.path.abspath(os.path.join(os.path.dirname(__file__), "../frontend"))
if os.path.exists(FRONTEND_DIR):
    app.mount("/", StaticFiles(directory=FRONTEND_DIR, html=True), name="frontend")


if __name__ == "__main__":
    import uvicorn
    # Use port 8050 to avoid conflicts with macOS AirPlay Receiver (which uses port 8000)
    uvicorn.run("main:app", host="0.0.0.0", port=8050, reload=True)
