SohamBhavsar24/vision-autonomous-robotic-arm/(commit log)

2026-07-23 Initial commit: project foundation
    - Architecture document (architecture.md)
    - Agent bible for AI context continuity (agent_bible.md)
    - Append-only decision log with 17 decisions (decisions.md)
    - Antigravity rules file (.gemini/rules.md)
    - Arduino servo calibration firmware (firmware/servo_calibration/)
    - Arduino production robot driver firmware (firmware/robot_driver/)
    - Firmware README with wiring diagram
    - Project README with structure overview
    - .gitignore for Python, macOS, datasets, model checkpoints
    - College synopsis PDF
2026-07-23 Add firmware files: calibration script, robot driver, firmware README
2026-07-23 Log Decision #19: Dashboard Phase A as physical assembly and testing tool
2026-07-24 Build Dashboard Phase A: Warm Cream UI, FastAPI backend, WebSockets, 6-DOF servo sliders, Lock 90° assembly assistant, E-Stop, and serial manager
2026-07-24 Fix method definition syntax errors in serial_manager.py
    [serial_manager.py]
2026-07-24 Switch dashboard port to 8050 to prevent macOS AirPlay Receiver port 8000 conflicts
    [main.py]
2026-07-24 Integrate arduino-cli JSON board detection and block virtual macOS debug ports
2026-07-24 Add 'Run Joint Sweep Test' button with live synchronized slider movement and auto-return to Home
2026-07-24 Implement Cosine S-Curve minimum-jerk trajectory interpolation for smooth zero-jerk servo movements (Decision #20)
2026-07-24 Fix WebSocket slider update binding and enable live smooth S-Curve trajectory gliding for Sweep, Home, and Lock 90
    [main.py]
2026-07-24 Convert smooth S-Curve trajectory engine to non-blocking asyncio tasks for 30Hz live WebSocket slider animation
2026-07-24 Fix WebSocket telemetry handler in app.js to drive ServoPanel sliders live frame-by-frame
2026-07-24 Cache arduino-cli subprocess check to eliminate 30Hz WebSocket streaming latency
2026-07-24 Add live Kinematic Calibration & DH fine-tuning card to Teleoperation tab with persistent JSON storage (Decision #21)
2026-07-24 Add 3D Digital Twin (Baby ROS / URDF integration) card to Web Dashboard (Decision #22)
2026-07-24 Reorder Digital Twin to final sidebar tab position, update status pill to 'Standing By (Awaiting URDF)', and anonymize text
2026-07-24 Remove small 3D Digital Twin preview card from Servo Control panel
2026-07-24 Add solo servo diagnostic test buttons ('Test Solo') for individual joint verification during physical assembly
2026-07-24 Add Stage 1 ArUco marker generator script and printable 4cm x 4cm HTML sheet (Decision #2)
2026-07-24 Log Decision #24: Origin ArUco Marker for automatic real-world coordinate calibration
2026-07-24 Log Decision #25: Place Calibration ArUco Marker ID 2 in corner near camera pole to prevent arm occlusion
2026-07-24 Update Decision #25 with exact centered camera pole and right-corner positive coordinate geometry
2026-07-24 Log Decision #26: World Frame Corner Origin (Marker 2 at 0,0) for 100% positive platform coordinates
2026-07-24 Add floating + button, auto-date generator, modal, and GitHub Pages free hosting for project journal
2026-07-24 Convert Project Journal into native iPhone PWA app with home screen icon and remove backup button
2026-07-24 Upgrade Apple Touch Icon to premium 3D robotic arm manipulator graphic for iOS Home Screen
2026-07-24 Update agent_bible.md with Session 4 completion and immediate next steps for hardware assembly
2026-07-24 Clarify in agent_bible.md that platform geometry is planned design and only raw board exists currently
2026-07-24 Update Session 4 journal entry to clarify platform geometry as a planned blueprint prior to physical assembly
2026-07-24 Correction: Clarify that base position offset will be measured post-assembly, not hardcoded
2026-07-25 Add real-time header search bar, file attachments (PDFs/Videos/Images), and log deletion feature to Journal PWA app
2026-07-25 Automate background sync on Submit Entry/Delete Entry button clicks (removed extra UI sync buttons)
2026-07-25 Update Dashboard Journal tab iframe to embed live Vercel app URL (https://vision-autonomous-robotic-arm.vercel.app)
2026-07-25 Replace inline video/image player tags with clean 1-tap Download/View badges just like the Synopsis PDF button
2026-07-25 Add Cloud Media CDN Engine (tmpfiles.org) for zero-error cross-device video & attachment downloads across iPhone and Laptop Dashboard
2026-07-25 Streamline journal attachment system to focus 100% on PDF documents and images for 100% cross-device reliability
2026-07-25 Update agent_bible.md to document PDF attachment focus decision
2026-07-25 Fix PDF attachment URL target and increase DataURL sync threshold to 10MB so all PDF logs sync seamlessly
2026-07-25 Fix HTTP 413 Payload Too Large sync rejection by storing lightweight PDF attachment metadata for instant cloud database sync
2026-07-25 Fix PDF attachment download targeting so newly uploaded PDF files download their exact contents
2026-07-25 Preserve PDF attachment DataURL across cloud sync payload for seamless PDF downloads on laptop dashboard
2026-07-25 Fix cloud sync HTTP 413 error by sending lightweight safeEntries array to JSONBlob so all logs reflect instantly across all devices
2026-07-25 Make form submit non-blocking (0.01s instant UI update & modal close) with background cloud sync to eliminate submit button freezes
2026-07-25 Build Vercel Serverless PDF & Document Cloud Store (api/file.js) for 100% ad-free official Vercel PDF uploads & cross-device downloads
2026-07-25 Fix triggerDownloadAttachment Vercel PDF URL resolution so cloud-stored PDFs download directly without triggering local device missing alerts
2026-07-25 Fix HTTP 429 Rate Limiting by removing 5s polling loop and ensuring PDF DataURL persists for seamless cross-device downloads
2026-07-25 Fix PDF DataURL stripping bug in saveEntries so PDF attachment URLs are never stripped from cloud DB payloads
2026-07-25 Fix cloud DB sync payload size limit so all entries with or without PDF attachments reflect instantly across devices
2026-07-30 Block virtual Bluetooth audio devices (Stone352, Airdopes141, etc.) from serial ports list and refuse connection to non-USB devices
2026-07-30 Integrate logbook2.pdf and publish Entry #8 in Web Journal with Bluetooth serial filtering update
2026-07-31 Self-healing Vercel cloud DB API + 3s live auto-sync loop so new journal entries sync live across all devices without requiring manual page refreshes
2026-08-06 Fix Supabase PostgREST key normalization to ensure 100% reliable entry & media attachment saving
2026-08-06 Implement dual teleoperation modes (Cartesian IK vs Direct Joint Control) with PS5 button mapping engine and gaming HUD control diagrams
2026-08-06 Fix teleop mode switch button handler and replace dark PS5 diagrams with Warm Cream Linen palette images matching Decision #18
2026-08-06 Remove controller diagram image card and implement rock-solid mode switcher with dynamic text notes
2026-08-06 Expose global toggleTeleopMode function for 100% reliable Mode button clicks
2026-08-06 Update teleop mode button text and pill status to explicitly show Active vs Target mode on toggle
2026-08-06 Update agent_bible.md with Session 6 decisions, Supabase storage, dual teleop modes, and hardware assembly kickoff
2026-08-06 Implement live Servo Control sliders sync during Direct Joint PS5 teleoperation & log controller connection events in Activity Log
2026-08-06 Lock PRIME DIRECTIVE (100% Smooth Motion Policy with Zero Sudden Movements) into system rules, decisions log, and EMA teleop filtering
2026-08-06 Implement Velocity-Based Rate Integrator for PS5 analog joysticks and fix PS5 button detection (Cross, Circle, L1, R1, L2, R2)
2026-08-06 Allow Lock 90, Move to Home, and Joint Sweep Test routines to run unhindered even when Direct Joint Control is selected
2026-08-06 Update R2 Gripper control: resting at 10deg, slowly opens towards 180deg when R2 pressed, returns slowly to 10deg when released
2026-08-06 Implement full Gripper State Machine (resting 10deg, R2 heading towards 180deg, releasing R2 returns to 10deg, L2 locks/unlocks position)
2026-08-06 Add 3-degree threshold snapping to low-pass filter to guarantee angles reach exact integer limits (0, 10, 180) without stopping at 12, 13, 178, 2, 3
2026-08-06 Apply endpoint threshold snapping across ALL 6 servo sliders so Base, Shoulder, Elbow, Wrist Pitch, Wrist Roll, and Gripper all reach exact integer limits 0deg and 180deg
2026-08-06 Implement Phase C Demonstration Dataset Recording & Trajectory Replay (30Hz sampler, auto-homing on stop, latest-first ordering, Play & Delete actions)
2026-08-06 Add Live 6-Joint Telemetry readout box and active 'Replaying Trajectory...' button state with live frame progress
2026-08-06 Publish Journal Entry #10 to Supabase PostgreSQL & update agent_bible.md for Session 7 physical hardware wiring & assembly readiness
2026-08-06 UI refinement: remove extra Dataset headings text, fix Journal search box text overlap (Search...), and restore dustbin emoji (🗑️) on delete buttons
2026-08-06 Remove Open App in New Tab button and shift journal app iframe upwards to fill top space in panel-journal
2026-08-07 Update PCA9685 channel mapping to spaced even channels (0, 2, 4, 6, 8, 10) to prevent servo plug crowding
    [robot_driver.ino]
2026-08-07 Publish Journal Entry #11 to Supabase PostgreSQL, fix journal sync merging logic to prevent entry deletion, and update agent_bible.md for Base, Shoulder & Elbow assembly milestone
2026-08-07 Fix journal video attachment upload (x-upsert header, expanded video format regex, and error alert)
2026-08-07 Implement dual hybrid media upload engine (FastAPI /api/upload + Supabase Cloud fallback) for zero-friction video attachments
2026-08-10 Fix 30Hz trajectory recorder angle sampling to capture live PS5/IK/teleop joint telemetry instead of static default angles
2026-08-13 Fix base motor jitter via serial buffer alignment flushing and reverse joystick directions for Base and Elbow in Direct Joint Mode
    [robot_driver.ino, serial_manager.py]
2026-08-13 Implement 0xFF Start-of-Frame Header Byte Framing to eliminate 30Hz stream packet desynchronization jitters
    [robot_driver.ino, serial_manager.py]
2026-08-13 Fix false constantly-true isUserInteracting condition in teleop_panel.js to stop 60Hz continuous WebSocket flooding
2026-08-13 Add 400kHz Fast I2C mode and unchanged-angle PCA9685 PWM filtering to eliminate analog servo chatter during continuous streaming
2026-08-13 Implement sub-step pulse-level EMA low-pass smoothing and stale buffer flushing to eliminate integer staircase servo motor chatter
2026-08-13 Implement exact float pulse mapping (150.0f + angle * 2.5f) and heavy 0.30 EMA filter to erase residual micro-jitters
    [robot_driver.ino]
2026-08-13 Revert robot_driver.ino back to 0ebf8e9 state (which reduced jitters tremendously)
    [robot_driver.ino]
2026-08-13 Update agent_bible.md with Session 8 accomplishments and next steps for complete arm assembly
2026-08-14 Update physical Gripper calibration: Open resting Home position set to 165 deg, closing motion moves from 165 down towards 90 with R2, releasing R2 returns to 165, and L2 locks position
2026-08-14 Enforce strict 85 deg minimum closing limit for Gripper with hardware-level Arduino clamping to eliminate motor stall & gear strain
    [main.py, robot_driver.ino, serial_manager.py]
2026-08-14 Update Gripper Open calibration angle to 145 deg (Range: 85 deg closed to 145 deg open)
2026-08-14 Update Gripper Open calibration angle to 140 deg and enforce strict package-level clamping (never send >140 deg or <85 deg)
2026-08-14 Bind PS5 Options button (Button 9) to smoothly move arm to Home Position [90, 90, 90, 90, 90, 140]
2026-08-14 Implement live OpenCV ArUco Marker ID 0 detection stream & dual camera dashboard layout
2026-08-14 Fix OpenCV 5.0 ArUco ArucoDetector API, grayscale preprocessing, and multi-dictionary fallback
    [vision_manager.py]
2026-08-14 Add graceful FastAPI shutdown hook for vision manager to release camera instantly on single Ctrl+C
2026-08-14 Regenerate 100% mathematically exact official OpenCV DICT_4X4_50 ArUco tags and print sheet
2026-08-14 Update agent_bible.md with Session 9 achievements: Physical arm assembly, live OpenCV vision stream, and presentation prompt
2026-08-15 Add direct Download Video and Download Image buttons with cross-origin Blob helper to Journal PWA and Dashboard
2026-08-15 Implement Cosine S-Curve homing interpolation for PS5 Options button to ensure 100% smooth zero-jerk motion
2026-08-31 Implement 3D Analytical Inverse Kinematics and Forward Kinematics engine calibrated to physical link lengths L1=9.5cm, L2=12cm, L3=9cm, L4=14cm
2026-08-31 Wire 60 FPS Cartesian 3D IK teleoperation mode on PS5 controller (X/Y/Z joystick control)
2026-08-31 Fix mode toggle bug and initialize cartesianPos dynamically via Forward Kinematics for PS5 IK teleoperation
2026-08-31 Tune IK teleoperation velocity scale to 0.08cm/frame and enforce 3D workspace box clamping for silky-smooth control
2026-08-31 Implement Adaptive Pitch IK solver to guarantee 100% straight vertical (Z) and horizontal (X/Y) line trajectories without arc drift
    [ik_solver.py]
2026-08-31 Switch IK solver to 3-DOF Primary Joint Architecture (Base, Shoulder, Elbow) for 100% exact 3D Cartesian positioning without pitch coupling
2026-08-31 Implement Gripper Binary State paradigm (OPEN=0, CLOSED=1) with full 0-180 slider testing range, user open/close calibration inputs, and state dataset logging
2026-08-31 Add inline Gripper Open and Close angle input boxes directly inside Gripper Claw card on Servo Control Panel
2026-08-31 Fix gripper snap-back bug by persisting open/close input values and replacing instant snap jumps with smooth S-curve gliding transitions
2026-08-31 Fix backend hard-clamp and WebSocket status broadcast overwrite that was causing custom open/close gripper angles to snap back to 85/140
    [ik_solver.py, serial_manager.py]
2026-08-31 Add dual-layer browser localStorage and backend persistence for Gripper Open and Close input values so they stay restored across page reloads
2026-08-31 Fix backend startup initialization so serial_manager loads persisted gripper angles from kinematics_config.json on server start
    [main.py, serial_manager.py]
2026-08-31 Fix missing import os in serial_manager.py that caused uvicorn startup NameError
    [serial_manager.py]
2026-08-31 Update PS5 controller homing routine to use dynamic user-calibrated Gripper Open angle
2026-08-31 Fix Base motor lag and sudden limit snapping bug by eliminating state conflict reset in teleop_panel animation loop
2026-08-31 Update dataset trajectory recording to store 5 primary joint angles and binary gripper_state (0=OPEN, 1=CLOSED) with dynamic open/close angle playback
2026-08-31 Log Entry 12: Add 25cm x 25cm workspace definition and 75-episode dataset collection strategy to capstone journal
2026-08-31 Update agent_bible.md with Session 11 status, Supabase PostgreSQL sync, Gripper Binary State paradigm, and 75-episode dataset blueprint
2026-08-31 Remove Camera 2 placeholder slot and expand Camera 1 live MJPEG video stream to full width (520px height)
2026-09-08 Add live pixel coordinates, orientation angle theta, heading direction vector, and dual-mode HUD display for ArUco tags on Camera 1 video stream
2026-09-08 Add World Origin coordinate axis (+X red, +Y green) and vector distance line between Tag ID 2 and Tag ID 0 on Camera 1 feed
2026-09-08 Log Entry 13: Define 25cm x 30cm workspace grid (30 cells) and progressive 30/60/90 demonstration evaluation protocol
2026-09-09 Invert elbow joint teleoperation direction and add base safety clamp
2026-09-09 Fix initial_block_pose serialization in dataset_formatter and add live vision status indicator to Dataset panel
    [dataset_formatter.py]
2026-09-09 Fix replay button state reset and endPose extraction in playEpisode Phase 3
2026-09-09 Implement Tri-Anchor Joint-Space Trajectory Blending and fix workspace axis normalization (X:30cm, Y:25cm)
    [autonomous_runner.py, train_policy.py, train_policy_engine.py]
2026-09-09 Fix roll angle jumping to 135 deg by removing synthetic theta compensation
    [autonomous_runner.py]
2026-09-09 Implement 4-fold canonical square roll compensation with [50, 120] range clamp
2026-09-09 Enforce 100% pure demonstrated trajectories with zero block orientation offsets on all joints
2026-09-20 feat(digital-twin): add Three.js 3D digital twin using CAD STLs and dedicated ROS 2 architecture panel
    [Arm 01.STL, Arm 02 v3.STL, Arm 03.STL, Base.STL, Gripper 1.STL, Gripper base.STL, Waist.STL, gear1.STL]
2026-09-20 fix(digital-twin): place waist on top of base, fix toggle grid and reset camera buttons, and remove unwanted info cards
2026-09-20 fix(digital-twin): sequential linkage alignment for Arm 03 and Gripper base, plus dual-gear 4-link parallel gripper assembly
2026-09-20 fix(digital-twin): mate vertical wall holes of Arm 03 and Gripper base, streamline to 2 Gripper 1 claws, and add digital space claw tuner
2026-09-20 Fix digital twin kinematics: swap theta 4 roll and theta 5 pitch, align Gripper 1 claws and mating holes
2026-09-20 Restore Arm 03 and Gripper base transforms, keep correct axis kinematics, and exchange claw orientations to face inward
2026-09-20 Expand claw tuner with full customization suite: per-claw X/Y/Z rotations, mirroring, upside down flips, and quick presets
2026-09-20 feat(digital-twin): add per-claw independent XYZ position controls and fix claw rotation axis to base hole
2026-09-20 feat(digital-twin): add save configuration button and persistence across browser and backend
2026-09-20 fix(digital-twin): rotate Waist STL 180 degrees to face forward direction
2026-09-23 fix(digital-twin): invert Y axis mapping so Y=0 aligns with near edge in front of arm
2026-09-23 feat(poster): add standalone high-res A0 research poster webpage with drag-and-drop image slots
2026-09-26 feat(autonomous): redesign continuous loop with 1.0s stability meter, update agent bible, and add CAD STEP assets
    [Arm 01.STL, Arm 02 v3.STL, Arm 03.STL, Base.STL, Gripper 1.STL, Gripper base.STL, Robotic Arm 3D Model.STEP, Waist.STL]
2026-09-26 feat(digital-twin): add 3D mesh table penetration prevention, safe angle revert, and toggle button
2026-09-26 feat(journal): restore dustbin emoji on delete entry button
2026-09-27 feat(perception): consolidate camera feeds into unified spatial workspace radar panel
2026-09-27 feat(digital-twin): add set camera default and WASD free-flight navigation HUD
2026-09-27 feat(digital-twin): persist default camera view to backend disk and localStorage
2026-09-27 docs(bible): formalize dynamic Gripper Open Angle calibrated from Servo Control panel
2026-09-27 docs(bible): codify Decision 37 single source of truth for dynamic Gripper Open Angle
2026-09-27 fix(security): scrub hardcoded Supabase keys and proxy journal sync via backend .env
    [main.py]
2026-09-27 refactor(perception): expand camera stream viewport to span 8 and remove radar grid lines
2026-10-01 feat(teleop): implement drop target calibration UI and PS5 D-Pad controls
2026-10-01 fix(autonomous): implement phase-aligned IDW blending and multi-model dataset routing
    [autonomous_runner.py]
2026-10-01 fix(act): resolve grasp trigger and lift termination in ACT rollout trajectory
    [train_act_engine.py]
2026-10-01 UI: move edit/delete buttons to card footer with dustbin emoji
